RonaldSchotman/Zebro/ReadMe.txt

This is the root of the Zebro Archive

Although the modules of different Zebro's should be interchangeable, they are organised according to the Zebro type that they are designed for.
