RonaldSchotman/Zebro/DeciZebro/LegModule/Hardware/Motor_driver_V1.0_ordered/Motor_driver_Mathijs/BOM_motor_driver_mathijs.xlsx

BOM power system
 |  |  |  |  | Total price | 33.36
Description | Value | Schematic Sheet | KiCad reference | Amount | Price | Price total | Manufacuter | Supplier | Ordercode | Artikel nr. | link
Resistors
Resistor 0603 | 120E |  | R7, R8 | 2 | 0.0126 | 0.0126 | YAGEO | Farnell | 9238379 | RC0603FR-07120RL | Link (http://nl.farnell.com/yageo-phycomp/rc0603fr-07120rl/res-thick-film-120r-1-0-1w-0603/dp/9238379)
Resistor 0603 | 150E |  | R19, R20, R21 | 3 | 0.0103 | 0.0309 | WELWYN | Farnell | 2078902 | ASC0603-150RFT5 | Link (http://nl.farnell.com/welwyn/asc0603-150rft5/res-thick-film-150r-1-0-1w-0603/dp/2078902)
Resistor 0603 | 2k7 | ATXmega, Driver, Sensors | R6, R9, R10, R14, R15 | 5 | 0.01 | 0.05 | WALSIN | Farnell | 2502439 | WR06X2701FTL | Link (http://nl.farnell.com/walsin/wr06x2701ftl/resistor-thick-film-2k7-1-75v/dp/2502439)
Resistor 0603 | 10k | Driver, ATXmega | R3 | 1 | 0.0038 | 0.0038 | Multicomp | Farnell | 2447230 | MCWR06X1002FTL | Link (http://nl.farnell.com/multicomp/mcwr06x1002ftl/res-thick-film-10k-1-0-1w-0603/dp/2447230)
Resistor 0603 | 16.9k |  | R1 | 1 | 0.0035 | 0.0035 | Multicomp | Farnell | 2447263 | MCWR06X1692FTL | Link (http://nl.farnell.com/multicomp/mcwr06x1692ftl/res-thick-film-16-9kohm-1-0-1w/dp/2447263)
Resistor 0603 | 22k |  | R4 | 1 | 0.0032 | 0.0032 | Multicomp | Farnell | 2447299 | MCWR06X2202FTL | Link (http://nl.farnell.com/multicomp/mcwr06x2202ftl/res-thick-film-22kohm-1-0-1w/dp/2447299)
Resistor 0603 | 47k |  | R12 | 1 | 0.0032 | 0.0035 | Multicomp | Farnell | 2447376 | MCWR06X4702FTL | Link (http://nl.farnell.com/multicomp/mcwr06x4702ftl/res-thick-film-47kohm-1-0-1w/dp/2447376)
Resistor 0603 | 68k |  | R13 | 1 | 0.0035 | 0.0035 | Multicomp | Farnell | 2447420 | MCWR06X6802FTL | Link (http://nl.farnell.com/multicomp/mcwr06x6802ftl/res-thick-film-68kohm-1-0-1w/dp/2447420)
Resistor 0603 | 330k |  | R5 | 1 | 0.004 | 0.004 | Multicomp | Farnell | 2447338 | MCWR06X3303FTL | Link (http://nl.farnell.com/multicomp/mcwr06x3303ftl/res-thick-film-330kohm-1-0-1w/dp/2447338)
Resistor 0603 | 100k | Buck Converter | R2 | 1 | 0.0079 | 0.0079 | YAGEO | Farnell | 9238727 | RC0603FR-07100KL | Link (http://nl.farnell.com/yageo-phycomp/rc0603fr-07100kl/res-thick-film-100k-1-0-1w-0603/dp/9238727)
Resistor 0603 | 1M |  | R11, R16, R17, R18 | 4 | 0.0013 | 0.0052 | Multicomp | Farnell | 9330410 | MC0063W060311M | Link (http://nl.farnell.com/multicomp/mc0063w060311m/res-thick-film-1m-1-0-063w-0603/dp/9330410)
Capacitors
Capacitor 0603 | 1u | Driver | C2, C10, C15, C16, C17 | 2 | 0.0251 | 0.0502 | Murata | Farnell | 9527699 | GRM188R60J105KA01D | Link (http://nl.farnell.com/murata/grm188r60j105ka01d/cap-mlcc-x5r-1uf-6-3v-0603/dp/9527699)
Capacitor 0603 | 100nF | Sensors, ATXmega | C5, C6, C9, C11, C12, C13, C14, C18, C19, C20, C21 | 11 | 0.0129 | 0.1419 | WALSIN | Farnell | 2496833 | 0603B104K250CT | Link (http://nl.farnell.com/walsin/0603b104k250ct/capacitor-mlcc-x7r-0-1uf-25v-0603/dp/2496833)
Capacitor 0603 | 2.2u | Buck Converter | C3 | 1 | 0.0986 | 0.0986 | Murata | Farnell | 2611926 | GRM188R6YA225KA12D | Link (http://nl.farnell.com/murata/grm188r6ya225ka12d/cap-mlcc-x5r-2-2uf-35v-0603/dp/2611926)
Capacitor 1206 | 22u | Buck Converter | C4 | 1 | 0.281 | 0.281 | YAGEO | Farnell | 1458914 | CC1206KKX5R5BB226 | Link (http://nl.farnell.com/yageo-phycomp/cc1206kkx5r5bb226/cap-mlcc-x5r-22uf-6-3v-1206/dp/1458914)
Capacitor 0603 | 1n |  | C7, C8 | 2 | 0.0059 | 0.0118 | Multicomp | Farnell | 2627426 | MC0603B102K250CT | Link (http://nl.farnell.com/multicomp/mc0603b102k250ct/cap-mlcc-x7r-1000pf-25v-0603/dp/2627426)
Capacitor | 22u |  | C1 | 1 | 0.014 | 0.014 | Multicomp | Farnell | 2611332 | MCVKZ016M220DA1L | Link (http://nl.farnell.com/multicomp/mcvkz016m220da1l/cap-alu-elec-22uf-16v-rad-can/dp/2611332)
Diodes
LED | KPH-1608SGC | ATXmega | D1, D2 | 2 | 0.0444 | 0.0888 | Kingbright | Farnell | 2426215 | KPH-1608SGC | Link (http://nl.farnell.com/kingbright/kph-1608sgc/led-green-12mcd-568nm-smd/dp/2426215)
TVS | CDSOD323-T08 | Connectors | D3 | 1 | 0.0236 | 0.0236 | Bourns | Farnell | 2341919 | CDSOD323-T08 | Link (http://nl.farnell.com/bourns/cdsod323-t08/diode-array-tvs-350w-8v-sod-323/dp/2341919)
Zener | MMSZ4684 |  | D4 | 1 | 0.0611 | 0.0611 | Fairchild | Farnell | 2454044 | MMSZ4684 | Link (http://nl.farnell.com/fairchild-semiconductor/mmsz4684/zener-diode-0-5w-3-3v-sod-123/dp/2454044)
Inductors
Inductor | 10uH | Buck Converter | L1 | 1 | 0.594 | 0.594 | Vishay/Dale | Mouser | 70-IFSC1515AHER100M0 | IFSC1515AHER100M01 | Link (http://nl.mouser.com/ProductDetail/Vishay/IFSC1515AHER100M01/)
IC's
DRV8871 | Motor driver | Motor system | U1 | 1 | 2.7 | 2.7 | TI | Mouser | 595-DRV8871DDAR | DRV8871DDAR | Link (http://nl.mouser.com/ProductDetail/Texas-Instruments/DRV8871DDAR/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)
SM451 | Hall-sensor | Sensors | U4 | 1 | 0.971 | 0.971 | Honeywell | Mouser | 785-SM451R | SM451R | Link (http://nl.mouser.com/ProductDetail/Honeywell/SM451R/)
NCT75MNR2G | Temperature sensor | Sensors | U6 | 1 | 0.604 | 0.604 | On Semiconductor | Mouser | 863-NCT75DR2G | NCT75DR2G | Link (http://nl.mouser.com/ProductDetail/ON-Semiconductor/NCT75DR2G/)
TPS62177 | Buck Converter | Buck Converter | U2 | 1 | 1.44 | 1.44 | TI | Mouser | 595-TPS62177DQCR | TPS62177DQCR | Link (http://nl.mouser.com/ProductDetail/Texas-Instruments/TPS62177DQCR/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)
ATXMEGA32D4 | ATXMEGA | Xmega | U7 | 1 | 2.87 | 2.87 | Atmel | Farnell | 1748558 | ATXMEGA32D4-AU | Link (http://nl.farnell.com/atmel/atxmega32d4-au/mcu-8bit-avr-xmega-32mhz-tqfp/dp/1748558)
TCUT1350 | Photo Encoder | Sensors | U3 | 2 | 1.57 | 3.14 | Vishay | Farnell | 2424451 | TCUT1350X01 | Link (http://nl.farnell.com/vishay/tcut1350x01/sensor-optical-3mm-phototransistor/dp/2424451)
ACS710 | Current Sensor | Sensors | U5 | 1 | 4.17 | 4.17 | Allegro | Farnell | 2057422 | ACS710KLATR-6BB-T | Link (http://nl.farnell.com/allegro-microsystems/acs710klatr-6bb-t/current-sensor-16soic/dp/2057422)
SRV05 | TVS diode 4 I/O |  | U18, U11 | 2 | 1.53 | 3.06 | Bourns | Farnell | 1824870 | CDSOT23-SRV05-4 | Link (http://www.farnell.com/datasheets/1915363.pdf?_ga=1.110976581.1356917053.1479124336)
PCA9517 | Buffer | Connectors | U10 | 1 | 0.912 | 0.912 | NXP | Farnell | 2212064 | PCA9517ADP | Link (http://nl.farnell.com/nxp/pca9517adp/ic-repeater-i2c-bus-8tssop/dp/2212064)
Overig
Conn 01x04 |  | Connectors | P3, P6 | 1 | 0.163 | 0.163 | Wurt Elektronik | Farnell | 2356155 | 61300411121 | Link (http://nl.farnell.com/wurth-elektronik/61300411121/header-2-54mm-pin-tht-vertical/dp/2356155)
Conn 02x01 screw |  | Connectors | P1, P4 | 2 | 0.937 | 1.874 | TE | Farnell | 2112482 | 282834-2 | Link (http://nl.farnell.com/te-connectivity-buchanan/282834-2/terminal-block-wire-to-brd-2pos/dp/2112482)
Conn 02x03 |  | Connectors | P5 | 1 | 0.161 | 0.161 | Harwin | Farnell | 1022231 | M20-9980346 | Link (http://nl.farnell.com/harwin/m20-9980346/connector-header-tht-2-54mm-6way/dp/1022231)
Conn 02x04 smd | Data | Connectors | P2 | 1 | 0.546 | 0.546 | Samtec | Farnell | 2056012 | TSM-104-02-T-DV | Link (http://nl.farnell.com/samtec/tsm-104-02-t-dv/header-2-54mm-smt-8way/dp/2056012)
Fuse |  |  |  | 1 | 2.72 | 2.72 | Littlefuse | Farnell | 9922407 | 0452004.NRL | Link (http://nl.farnell.com/littelfuse/0452004-nrl/fuse-antisurge-smd-4a/dp/9922407?MER=sy-me-pd-mi-acce)
Fuse holder |  | Connectors | F1 | 1 | 6.54 | 6.54 | Littlefuse | Farnell | 9943765 | 0154004.DRT | Link (http://nl.farnell.com/littelfuse/0154004-drt/fuse-smd-4a-omni-block-time-delay/dp/9943765)
