RonaldSchotman/Zebro/StandardReferences/Styleguide/introduction.tex

\epigraph{Consistency is what matters the most in triggering something important to your life}{\textit{Abdul Rauf}}
\section{Introduction}
 
When writing a report --- or any other document --- it can be hard to maintain a consistent style throughout your work.
Yet, consistency of style can have an enormous impact in how professional the end result looks.
Most people barely manage to maintain a single style when working individually, let alone when working in a team.
As an attempt to create consistency the work of our team, this style guide was created.
Please read it carefully, and add information as needed.
Also keep in mind that this is a \emph{dynamic} document.
Therefore you are expected to regularly check this document for changes.
