RonaldSchotman/Zebro/StandardReferences/Styleguide/styleguide.tex

\documentclass[11pt,a4paper]{article}
\usepackage[utf8]{inputenc}
\usepackage{amsmath}
\usepackage{amsfonts}
\usepackage{amssymb}
\usepackage{graphicx}
\usepackage{epigraph}
\usepackage{float}
\usepackage{cleveref}
\usepackage{caption}
\usepackage{booktabs}
\usepackage{siunitx}

\sisetup{exponent-product = \cdot, per-mode=fraction}

\title{Zebro Style Guide for Publications}
\date{\today}

\begin{document}
\maketitle
\tableofcontents
\clearpage

\include{introduction} \clearpage
\include{general} \clearpage
\include{figuresAndTables} \clearpage
\include{termsAndAbbreviations} \clearpage
\include{technicalNotation} \clearpage

\end{document}
