RonaldSchotman/Zebro/StandardReferences/Styleguide/termsAndAbbreviations.tex

\epigraph{Let all things be done decently and in order.
}{\textit{I Corinthians, XIV. 40.}}
\section{Terms and abbreviations}

\paragraph{Technical terms}
Unless otherwise specified,
use the primary notation used by the English Wikipedia for all technical terms.

\paragraph{Acronyms}
Always use the acronyms package for acronyms.

\paragraph{BAP}
When referring the the Bachelor graduation project, use the acronym BAP
