RonaldSchotman/Zebro/DeciZebro/LegModule/Hardware/Motor_driver_V1.0_ordered/Motor_driver_Mathijs/Motor_driver.pdf

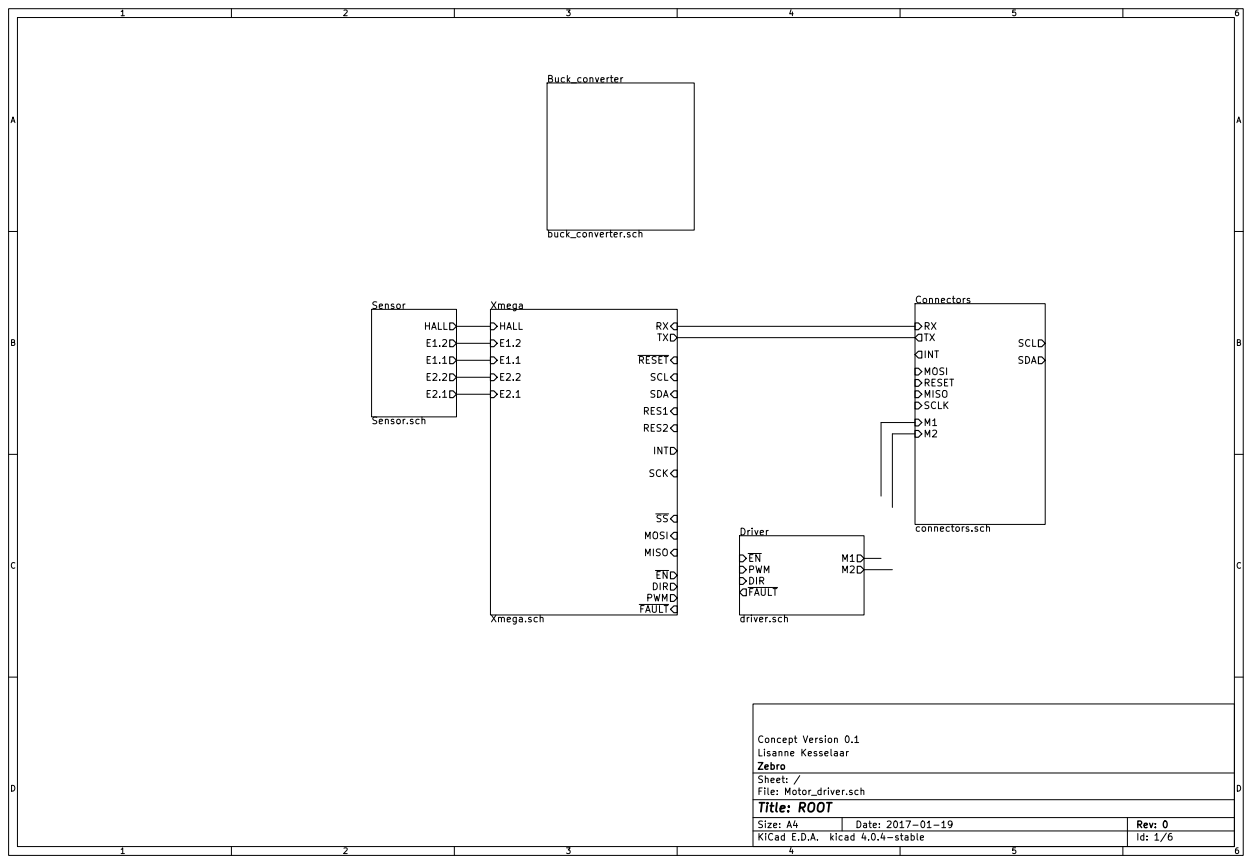
[picture p1: page 1]

Lisanne Kesselaar Concept Version 0.1

File: Motor_driver.sch Sheet: / Zebro

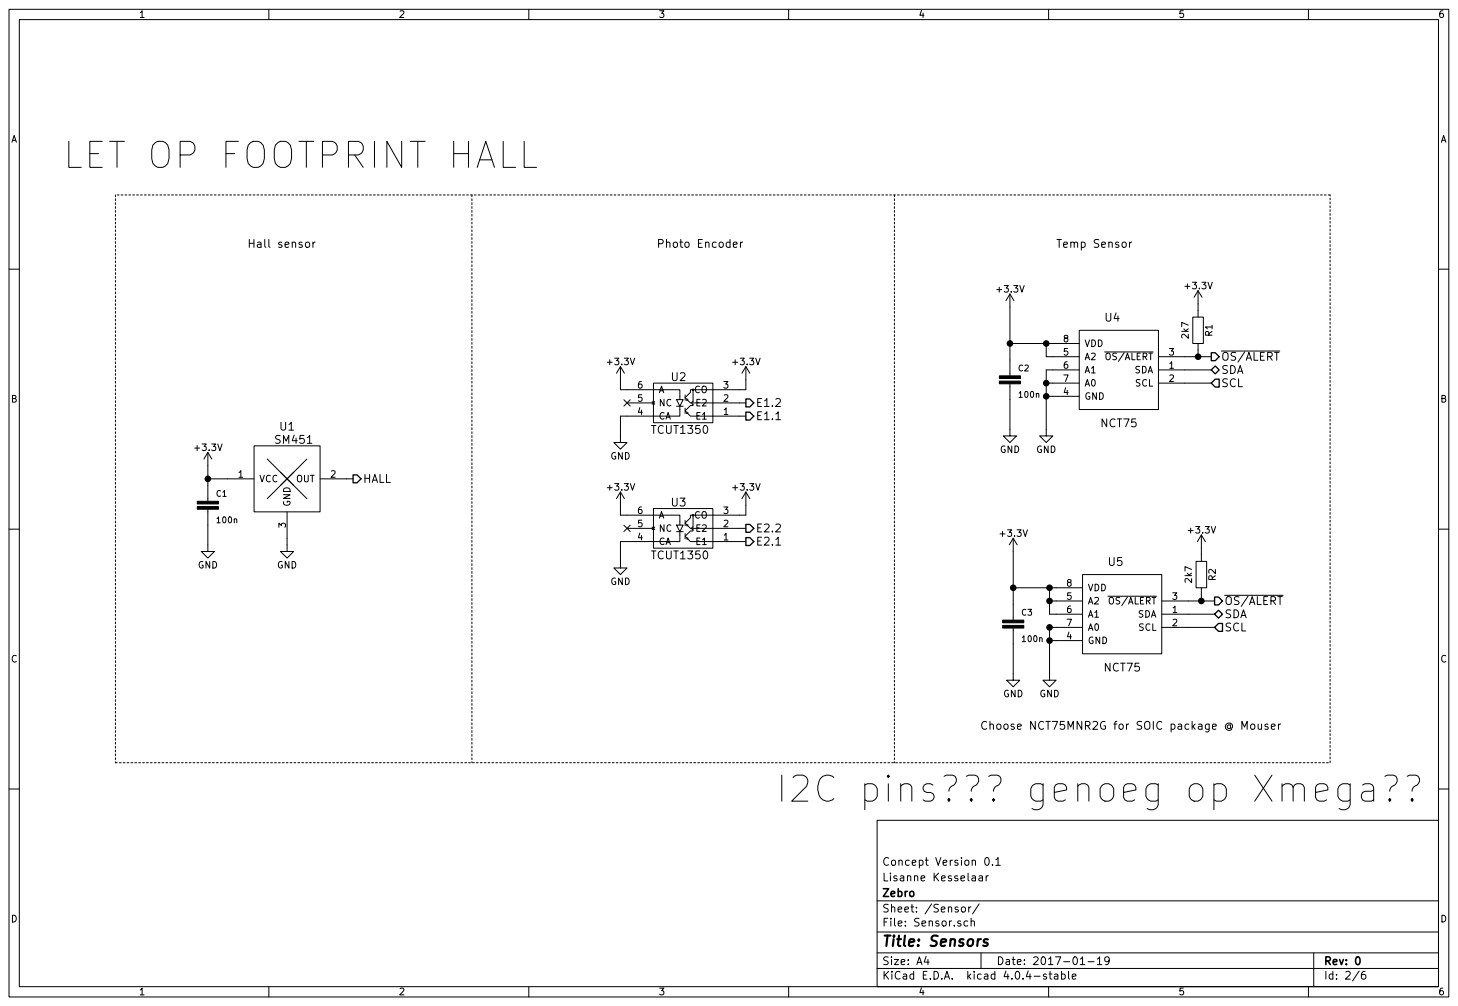
[picture p2: page 2]

Choose NCT75MNR2G for SOIC package @ Mouser

I2C pins??? genoeg op Xmega??

File: Sensor.sch Sheet: /Sensor/ Zebro

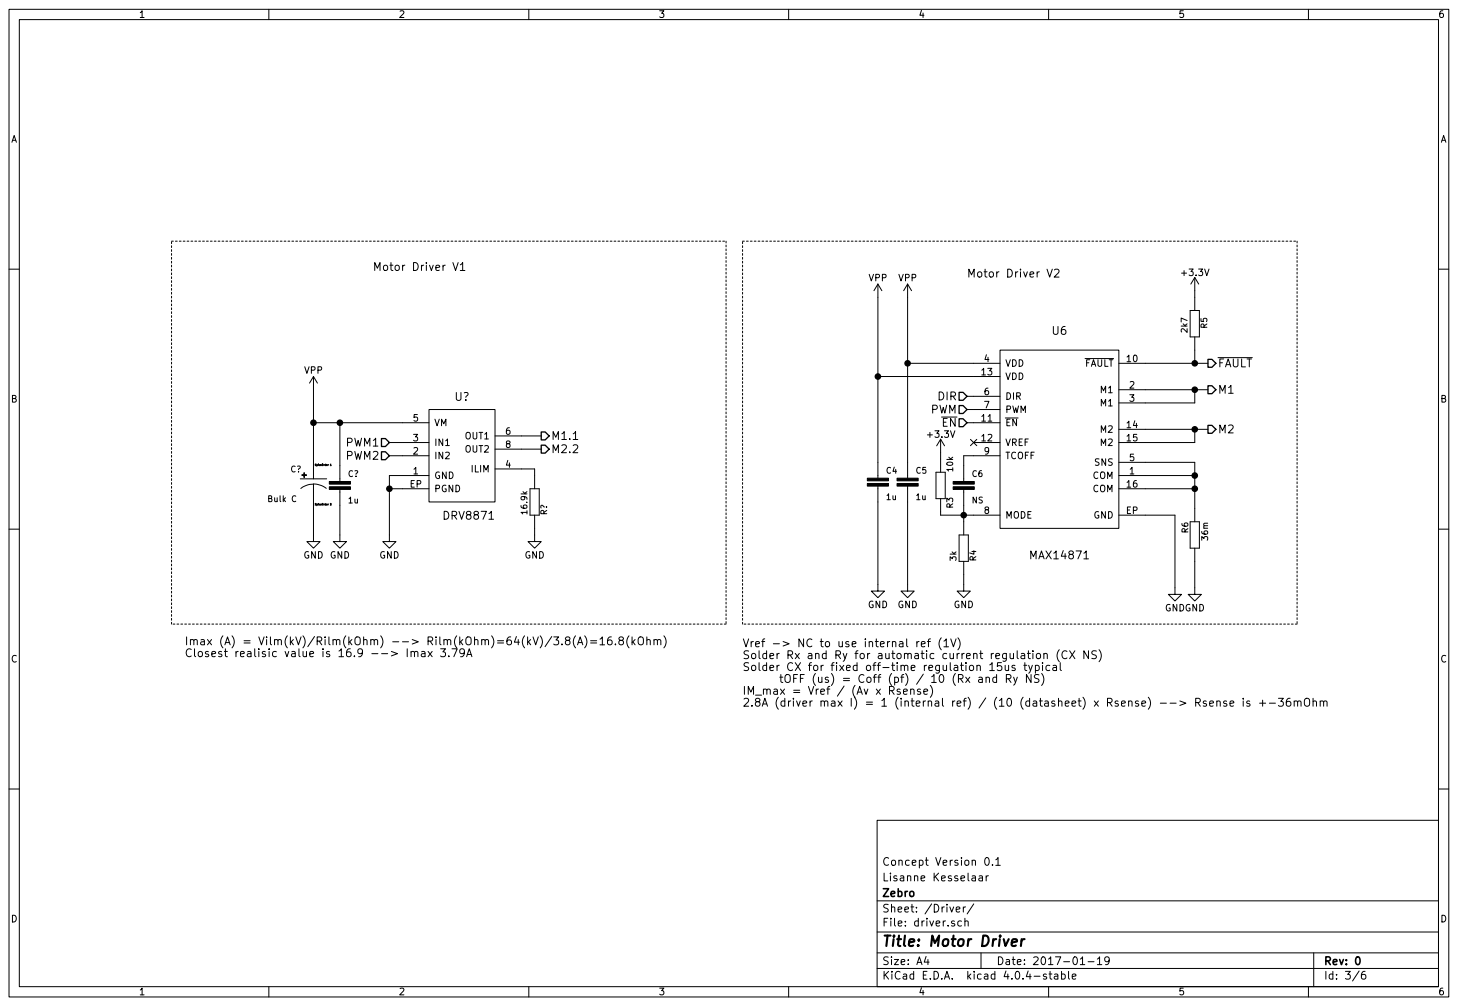
[picture p3: page 3]

C6 NS GND Vref -> NC to use internal ref (1V)

Imax (A) = Vilm(kV)/Rilm(kOhm) --> Rilm(kOhm)=64(kV)/3.8(A)=16.8(kOhm)
Closest realisic value is 16.9 --> Imax 3.79A

Solder Rx and Ry for automatic current regulation (CX NS)
Solder CX for fixed off-time regulation 15us typical
tOFF (us) = Coff (pf) / 10 (Rx and Ry NS)
IM_max = Vref / (Av x Rsense)

Id: 3/6 Title: Motor Driver File: driver.sch Sheet: /Driver/ Zebro

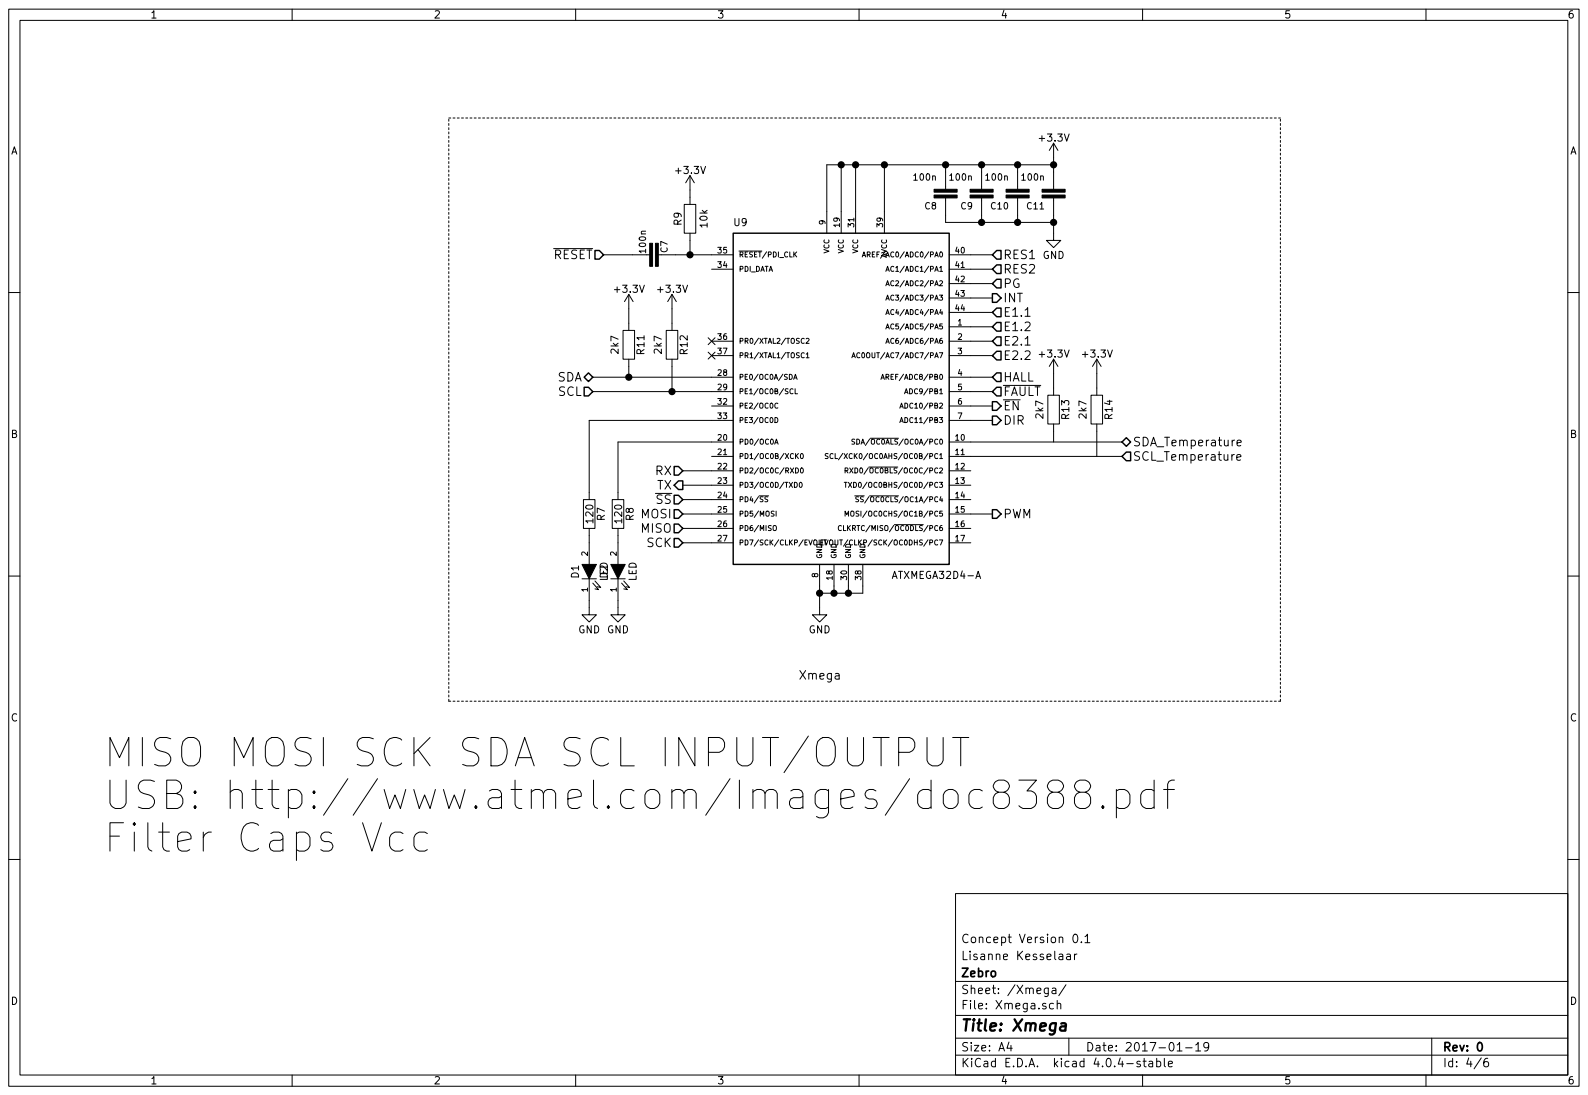
[picture p4: page 4]

9 SDA/OC0ALS/OC0A/PC0 10 PD0/OC0A 20 GND 30 AREF/AC0/ADC0/PA0 40 SCL/XCK0/OC0AHS/OC0B/PC1 11 PD1/OC0B/XCK0 21 VCC 31 AC1/ADC1/PA1 41 RXD0/OC0BLS/OC0C/PC2 12 PD2/OC0C/RXD0 22 PE2/OC0C 32 AC2/ADC2/PA2 42

1 2 D2 LED 120 R7 120 R8 GND GND PWM

MISO MOSI SCK SDA SCL INPUT/OUTPUT
USB: http://www.atmel.com/Images/doc8388.pdf
Filter Caps Vcc

Lisanne Kesselaar Concept Version 0.1

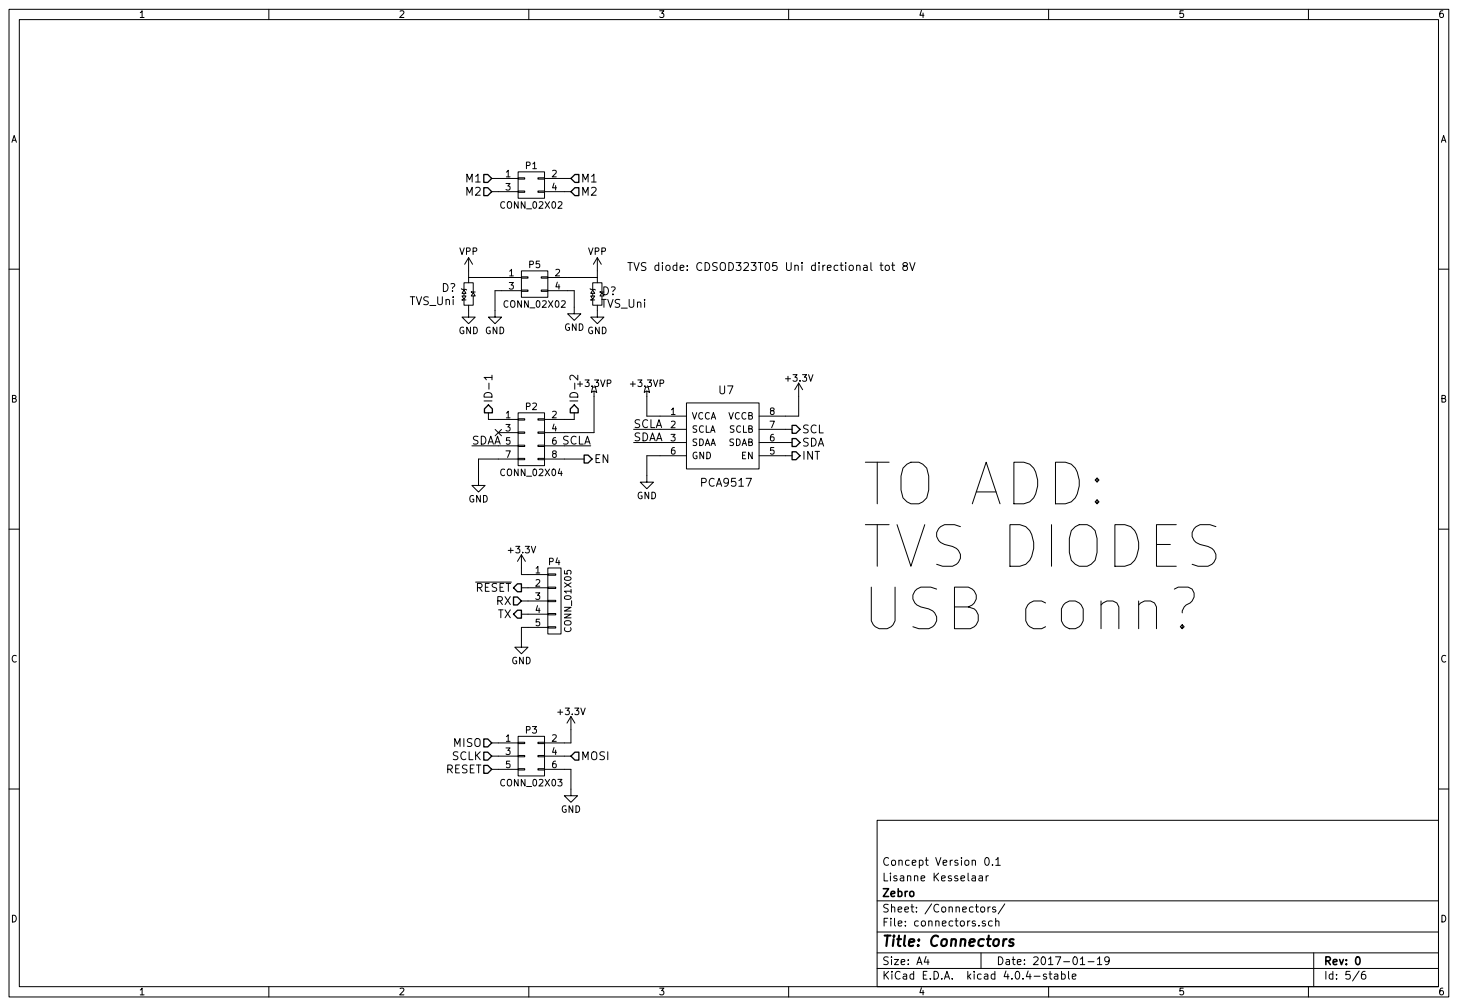
[picture p5: page 5]

Lisanne Kesselaar Concept Version 0.1

File: connectors.sch Sheet: /Connectors/ Zebro

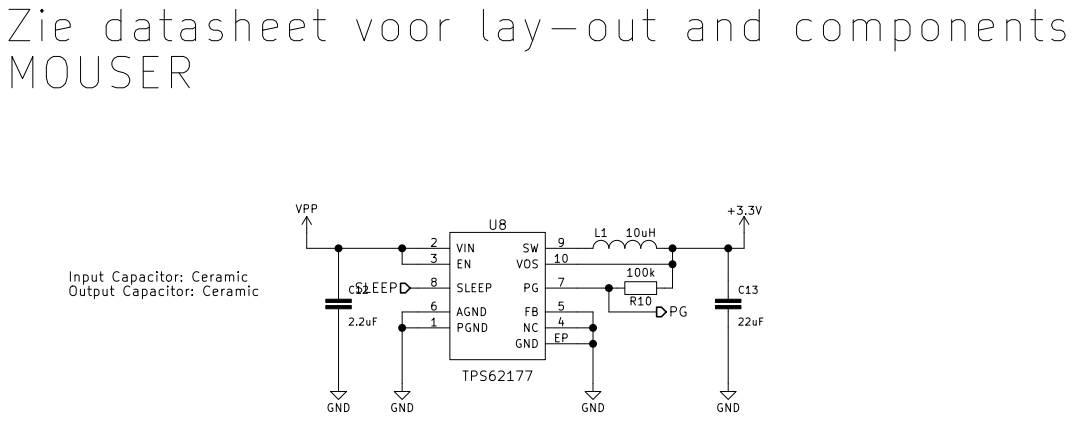
[picture p6: page 6]

File: buck_converter.sch
Id: 6/6 Title: Buck Converter
