RonaldSchotman/Zebro/DeciZebro/LegModule/Hardware/Motor_driver_V1.0_ordered/Motor_driver_Mathijs/Schema_pdf/Motor_driver.pdf

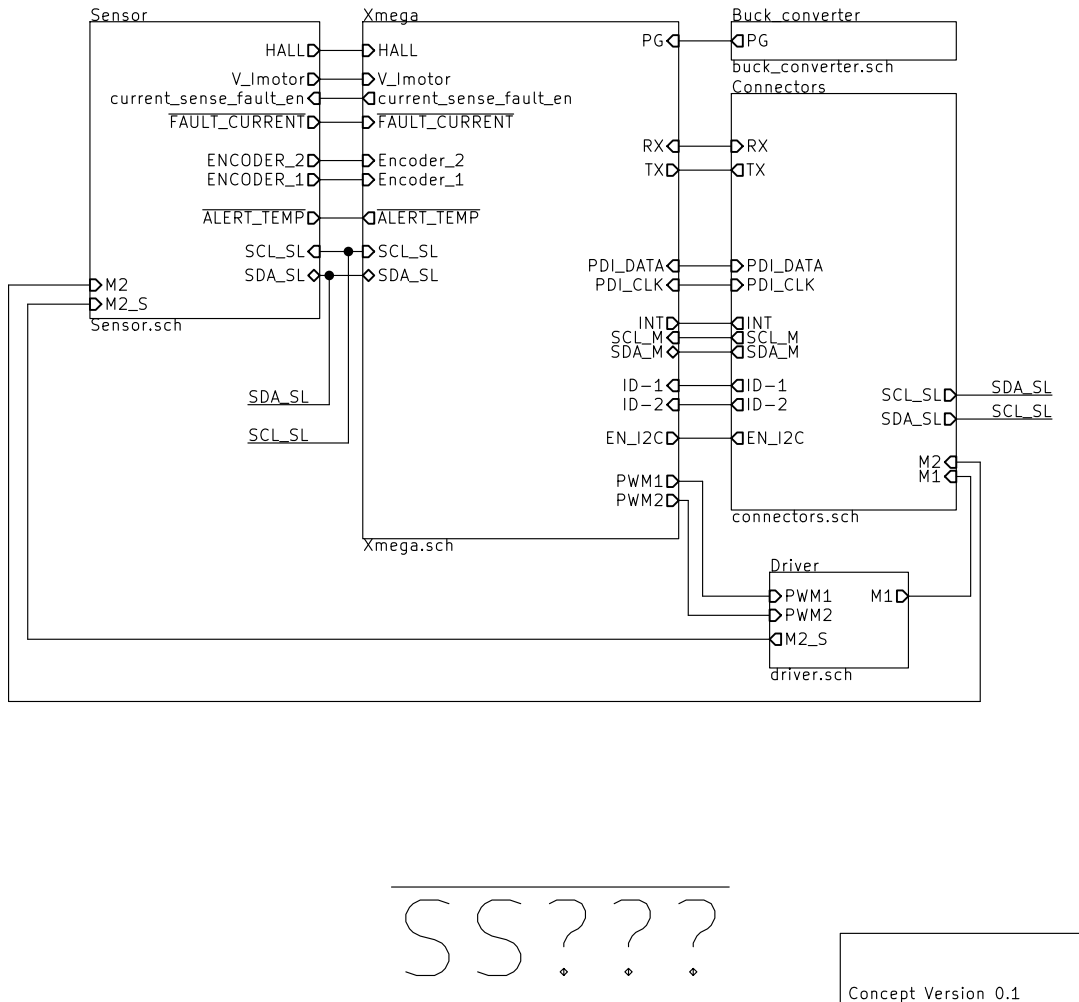
[picture p7: page 1]

File: Motor_driver.sch Sheet: / Zebro

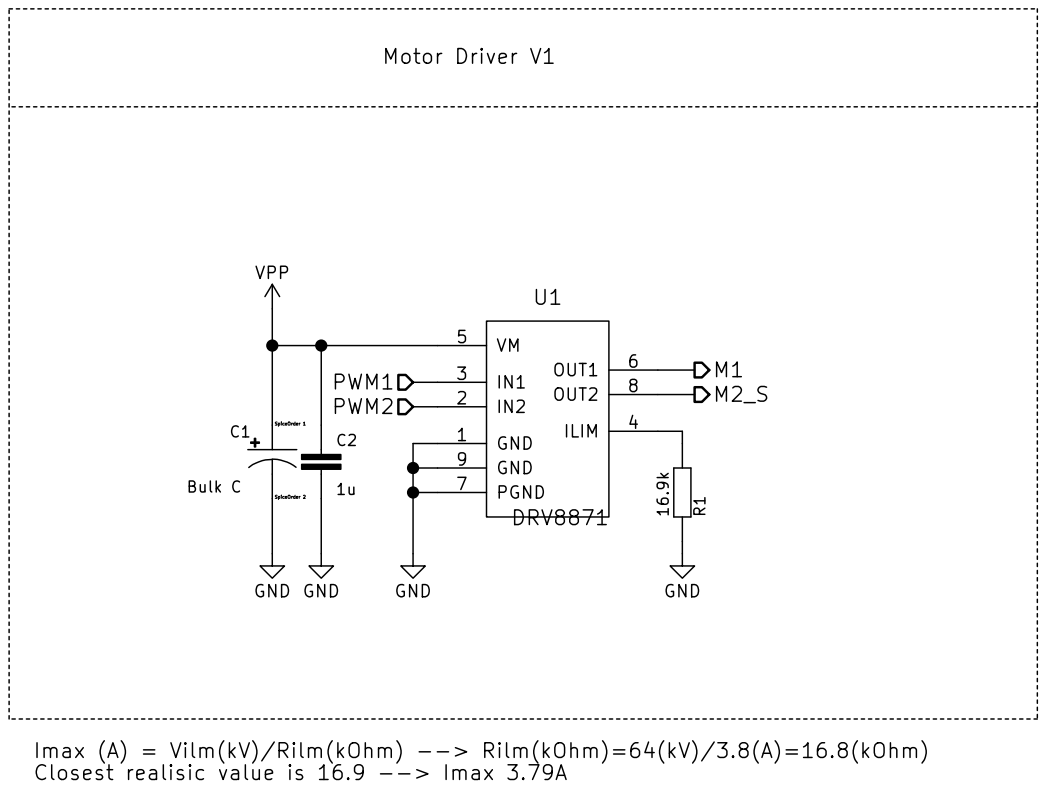
[picture p8: page 2]

Imax (A) = Vilm(kV)/Rilm(kOhm) --> Rilm(kOhm)=64(kV)/3.8(A)=16.8(kOhm)
Closest realisic value is 16.9 --> Imax 3.79A

Id: 2/6 Title: Motor Driver File: driver.sch Sheet: /Driver/ Zebro

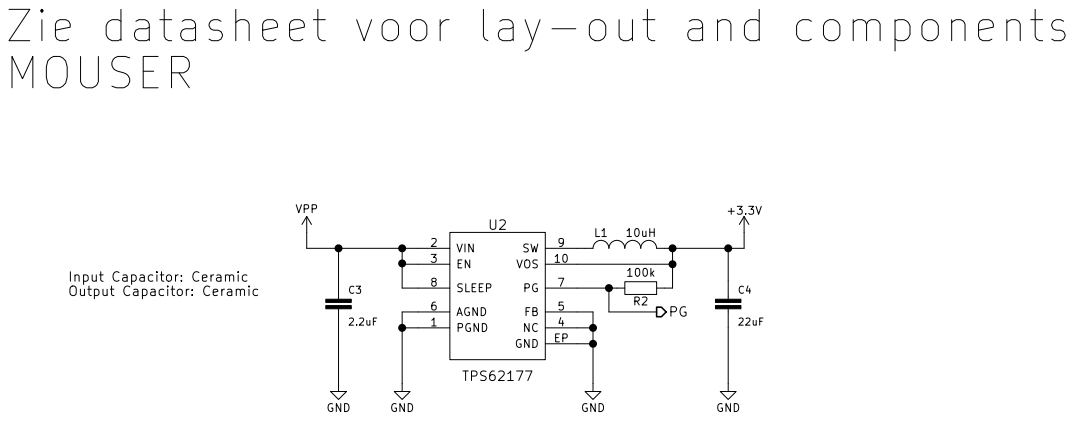
[picture p9: page 3]

+3.3V Zie datasheet voor lay-out and components
MOUSER

File: buck_converter.sch
Id: 3/6 Title: Buck Converter

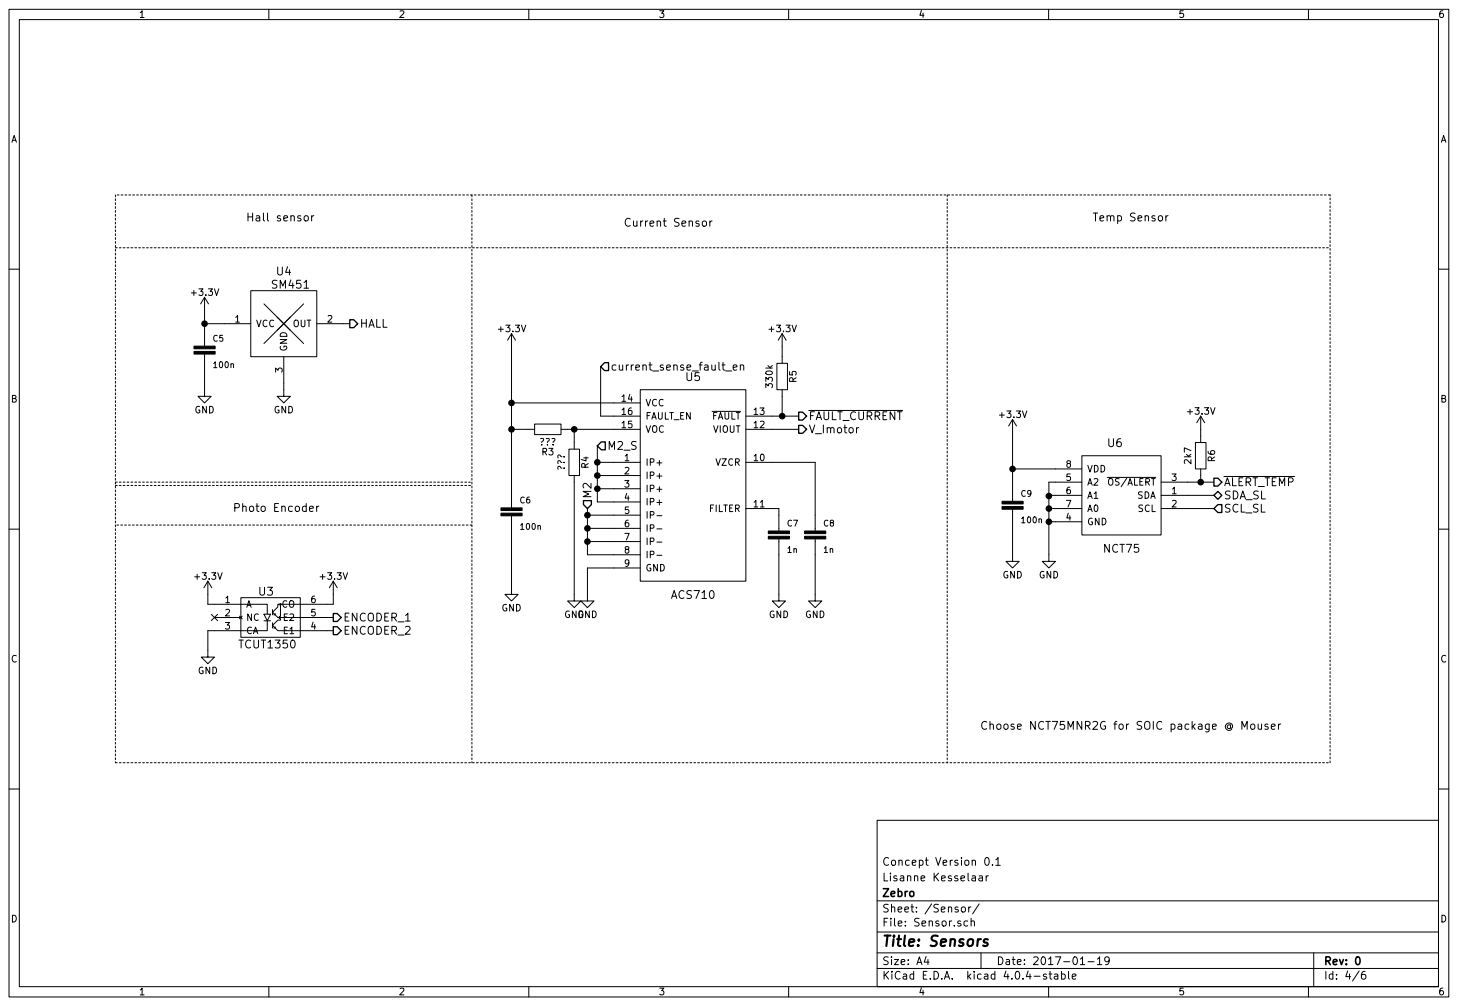
[picture p10: page 4]

File: Sensor.sch Sheet: /Sensor/ Zebro

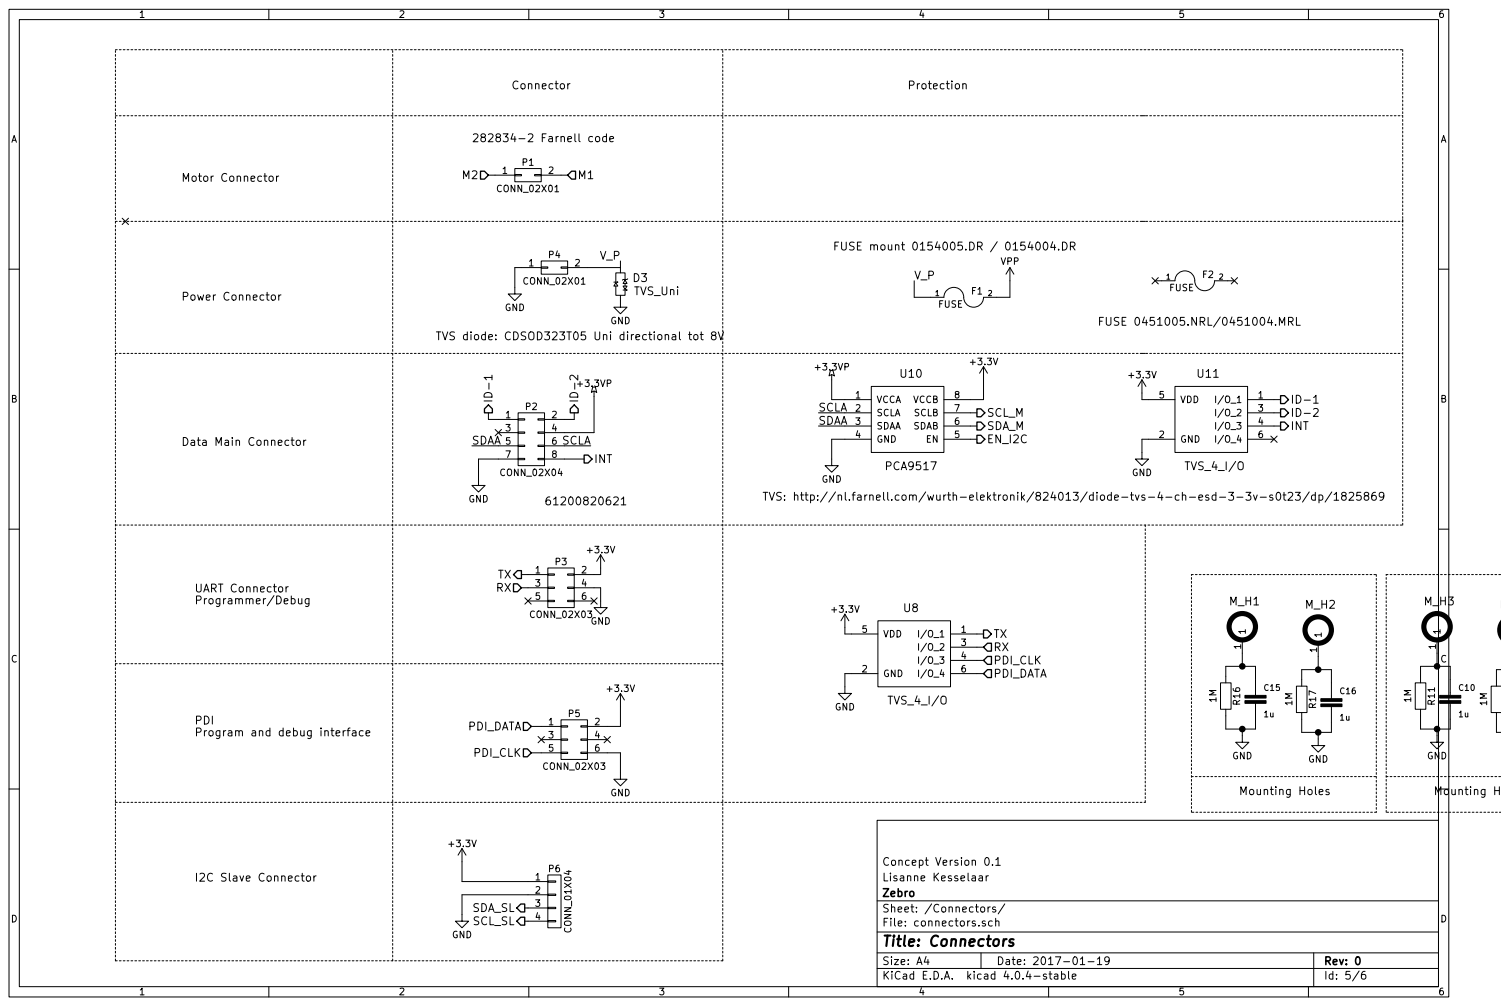
[picture p11: page 5]

VPP FUSE mount 0154005.DR / 0154004.DR

TVS: http://nl.farnell.com/wurth-elektronik/824013/diode-tvs-4-ch-esd-3-3v-s0t23/dp/1825869

UART Connector
Programmer/Debug PDI Program and debug interface

Lisanne Kesselaar Concept Version 0.1

File: connectors.sch Sheet: /Connectors/ Zebro

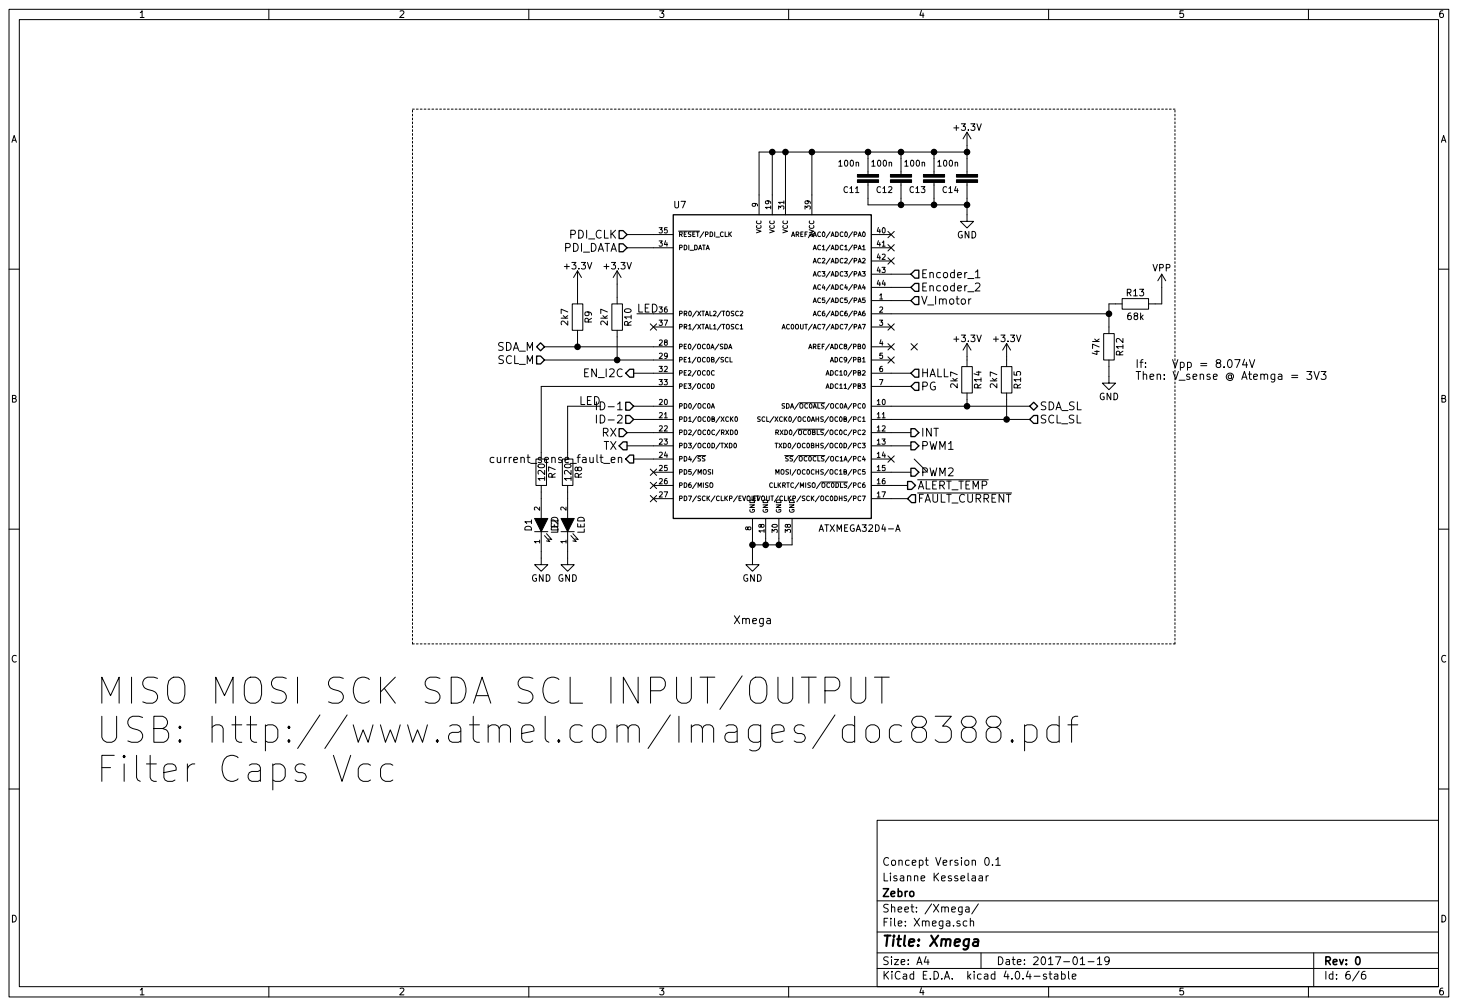
[picture p12: page 6]

9 SDA/OC0ALS/OC0A/PC0 10 PD0/OC0A 20 GND 30 AREF/AC0/ADC0/PA0 40 SCL/XCK0/OC0AHS/OC0B/PC1 11 PD1/OC0B/XCK0 21 VCC 31 AC1/ADC1/PA1 41 RXD0/OC0BLS/OC0C/PC2 12 PD2/OC0C/RXD0 22 PE2/OC0C 32 AC2/ADC2/PA2 42

1 2 D2 LED 120 R7 120 R8 GND GND PWM2 HALL MISO MOSI SCK SDA SCL INPUT/OUTPUT

USB: http://www.atmel.com/Images/doc8388.pdf
Filter Caps Vcc

Lisanne Kesselaar Concept Version 0.1
