RonaldSchotman/Zebro/DeciZebro/LegModule/Hardware/Motor_driver_V1.0_ordered/Motor_driver_Mathijs/Motor_driver.kicad_pcb

## KiCad design DeciZebro/LegModule/Hardware/Motor_driver_V1.0_ordered/Motor_driver_Mathijs/Motor_driver.kicad_pcb (2017-02-24)

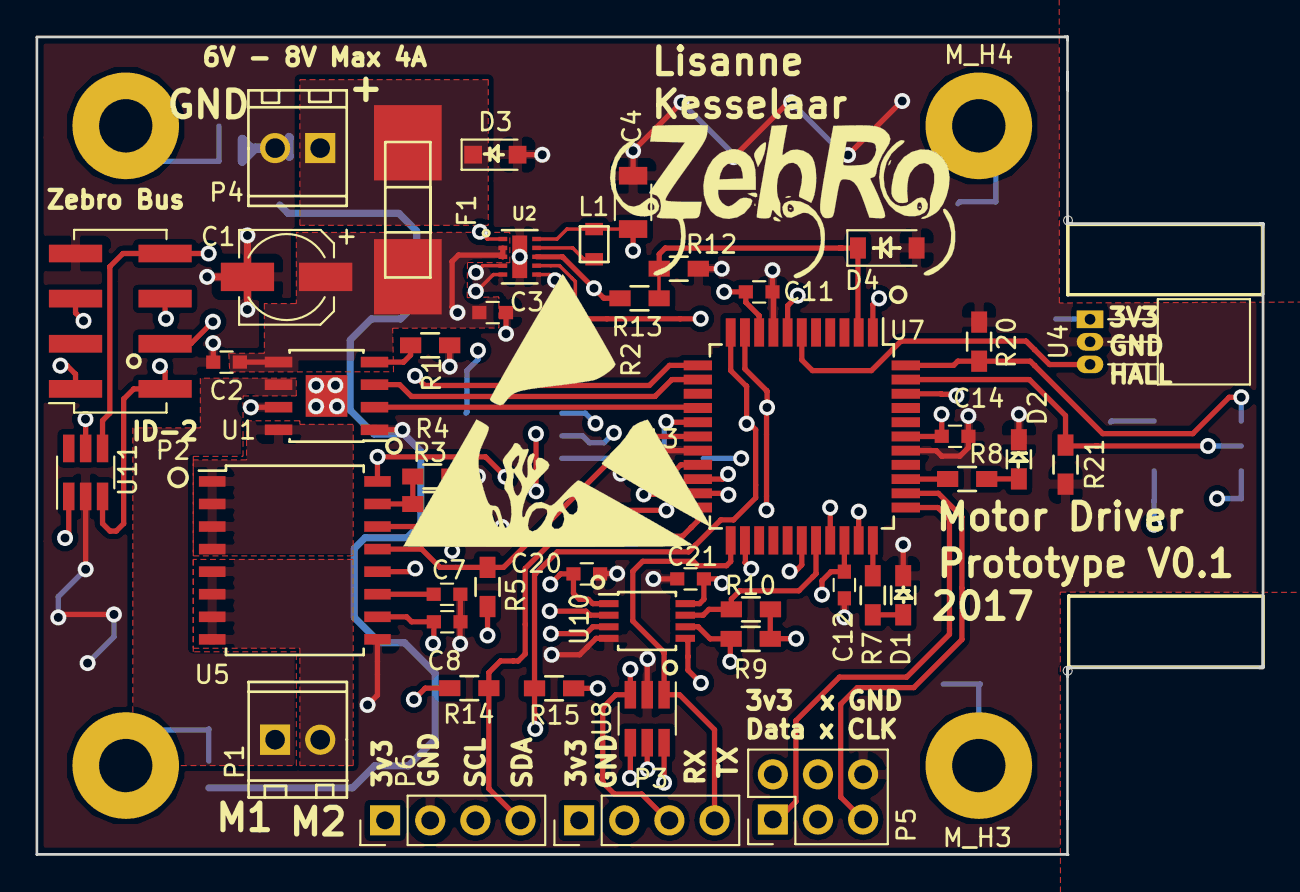
[picture p13: board Motor_driver.kicad_pcb from above]

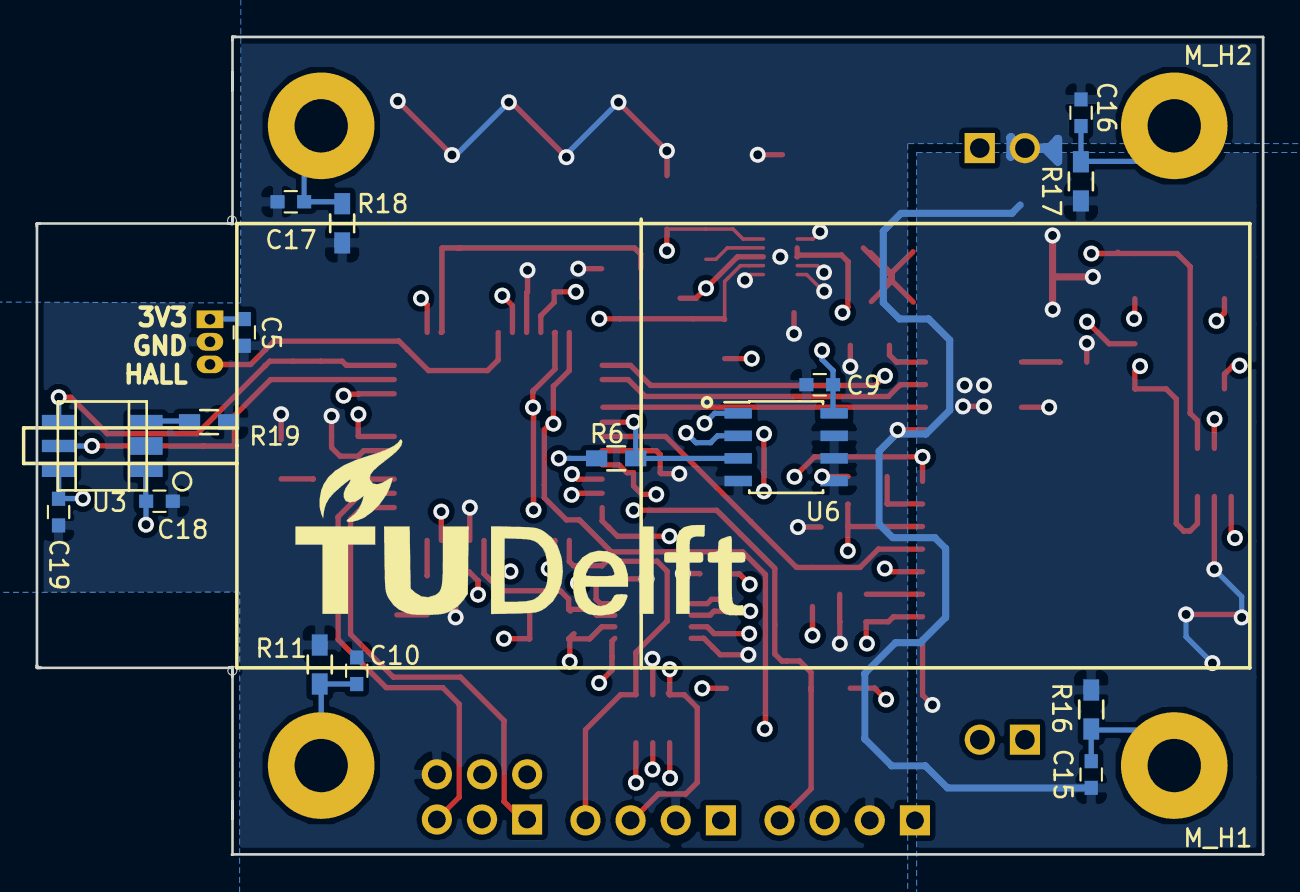
[picture p14: board Motor_driver.kicad_pcb from below]

Board: 4 copper layers, 69.0 x 46.0 mm, 68 parts (18 on the bottom side), 47 nets.

Parts:
C1: Bulk C; CP_Elec_5x5.3
C2, C10, C15, C16, C17: 1u; C_0603
C3: 2.2uF; C_0603
C4: 22uF; C_1206
C5, C6, C9, C11, C12, C13, C14, C18, C19, C20, C21: 100n; C_0603
C7, C8: 1n; C_0603
D1, D2: LED; R_0603_HandSoldering
D3: TVS_Uni; D_SOD-323_HandSoldering
D4: ZENER; D_SOD-123
F1: FUSE; litle_fuse_154_serie
L1: 10uH; Inductor-vishay-motor-driver
M_H1, M_H2, M_H3, M_H4: Mounting_Hole; MountingHole_3mm_Pad
P1, P4: CONN_02X01; screw_terimnal_2.54mm_pitch
P2: CONN_02X04; Socket_Strip_Straight_2x04_Pitch2.54mm_SMD
P3, P6: CONN_01X04; Pin_Header_Straight_1x04_Pitch2.54mm
P5: CONN_02X03; Pin_Header_Straight_2x03_Pitch2.54mm
R1: 16.9k; R_0603_HandSoldering
R2: 100k; R_0603_HandSoldering
R3: 10k; R_0603_HandSoldering
R4: 22k; R_0603_HandSoldering
R5: 330k; R_0603_HandSoldering
R6, R9, R10, R14, R15: 2k7; R_0603_HandSoldering
R7, R8: 120; R_0603_HandSoldering
R11, R16, R17, R18: 1M; R_0603_HandSoldering
R12: 47k; R_0603_HandSoldering
R13: 68k; R_0603_HandSoldering
R19, R20, R21: 150E; R_0603_HandSoldering
U1: DRV8871; SOIC-8-1EP_3.9x4.9mm_Pitch1.27mm
U2: TPS62177; WSON-10-2x3
U3: TCUT1350
U4: SM451; TO-92_Horizontal2_Inline_Narrow_Oval
U5: ACS710; SOIC-16W_7.5x10.3mm_Pitch1.27mm
U6: NCT75; SOIC-8_3.9x4.9mm_Pitch1.27mm
U7: ATXMEGA32D4-A; LQFP-44_10x10mm_Pitch0.8mm
U8, U11: TVS_4_I/O; SOT-23-6_Handsoldering
U10: PCA9517; TSSOP-8_3x3mm_Pitch0.65mm

Connections:
+3.3VP: C20.1, P2.4, U10.1
+3V3: C4.1, C5.1, C6.1, C9.1, C11.2, C12.2, C13.2, C14.2, C18.1, C19.1, C21.1, L1.2, P3.1, P5.2, P6.1, R2.1, R3.1, R5.1, R6.1, R9.1, R10.1, R14.1, R15.1, U2.10, U3.1, U3.6, U4.1, U5.14, U6.8, U7.9, U7.19, U7.31, U7.39, U8.5, U10.8, U11.5
/Buck_converter/PG: R2.2, U2.7, U7.7
/Connectors/EN_I2C: U7.32, U10.5
/Connectors/ID-1: P2.1, U7.20, U11.1
/Connectors/ID-2: P2.2, U7.21, U11.3
/Connectors/INT: P2.8, U7.12, U11.4
/Connectors/M1: P1.2, U1.6
/Connectors/M2: P1.1, U5.5, U5.6, U5.7, U5.8
/Connectors/PDI_CLK: P5.5, U7.35, U8.4
/Connectors/PDI_DATA: P5.1, U7.34, U8.6
/Connectors/RX: P3.3, U7.22, U8.3
/Connectors/SCLA: P2.6, U10.2
/Connectors/SCL_M: R10.2, U7.29, U10.7
/Connectors/SDAA: P2.5, U10.3
/Connectors/SDA_M: R9.2, U7.28, U10.6
/Connectors/TX: P3.4, U7.23, U8.1
/Connectors/V_P: D3.1, F1.1, P4.2
/Driver/M2_S: U1.8, U5.1, U5.2, U5.3, U5.4
/Driver/PWM1: U1.3, U7.13
/Driver/PWM2: U1.2, U7.15
/SCL_SL: P6.3, R15.2, U6.2, U7.11
/SDA_SL: P6.4, R14.2, U6.1, U7.10
/Sensor/ENCODER_1: R21.1, U3.5, U7.43
/Sensor/ENCODER_2: R20.1, U3.4, U7.44
/Sensor/HALL: U4.3, U7.6
/Sensor/V_Imotor: U5.12, U7.1
/Sensor/V_Imotor0V: C8.1, U5.10, U7.42
/Sensor/current_sense_fault_en: U5.16, U7.24
/Sensor/~ALERT_TEMP: R6.2, U6.3, U7.16
/Sensor/~FAULT_CURRENT: R5.2, U5.13, U7.17
/Xmega/LED: R8.1, U7.36
GND: C1.2, C2.2, C3.2, C4.2, C5.2, C6.2, C7.2, C8.2, C9.2, C10.2, C11.1, C12.1, C13.1, C14.1, C15.2, C16.2, C17.2, C18.2, C19.2, C20.2, C21.2, D1.1, D2.1, D3.2, D4.2, P2.7, P3.2, P4.1, P5.6, P6.2, R1.1, R4.2, R11.2, R12.2, R16.2, R17.2, R18.2, R19.2, R20.2, R21.2, U1.1, U1.7, U1.9, U2.1, U2.4, U2.5, U2.6, U2.EP, U4.2, U5.9, U6.4, U6.5, U6.6, U6.7, U7.8, U7.18, U7.30, U7.38, U8.2, U10.4, U11.2
unnamed: C7.1, U5.11
unnamed: C10.1, M_H3.1, R11.1
unnamed: C15.1, M_H1.1, R16.1
unnamed: C16.1, M_H2.1, R17.1
unnamed: C17.1, M_H4.1, R18.1
unnamed: D1.2, R7.2
unnamed: D2.2, R8.2
unnamed: D4.1, R12.1, R13.2, U7.2
unnamed: L1.1, U2.9
unnamed: R1.2, U1.4
unnamed: R3.2, R4.1, U5.15
unnamed: R7.1, U7.33
unnamed: R19.1, U3.3
VPP: C1.1, C2.1, C3.1, F1.2, R13.1, U1.5, U2.2, U2.3, U2.8
