RonaldSchotman/Zebro/DeciZebro/LegModule/Software/PootModule/PootModule/src/main.c

/**
 * Leg Module Deci Zebro
 * The Zebro Project
 * Delft University of Technology
 * 2017
 *
 * Filename: main.c
 *
 * Description:
 * Main file for the deci zebro leg module
 *
 * Authors:
 * Daniel Booms -- d.booms@solcon.nl
 *  
 */
#include <stdint.h>
#include <asf.h>
#include <avr/io.h>
#include "../inc/clock.h"
#include "../inc/globals.h"
#include "../inc/interrupts.h"
#include "../inc/leds.h"
#include "../inc/vregs.h"
#include "../inc/uart1.h"
#include "../inc/hbridge.h"
#include "../inc/errors.h"
#include "../inc/address.h"
#include "../inc/zebrobus.h"
#include "../inc/encoder.h"
#include "../inc/motion.h"

int main (void)
{
	/*some debugging code*/
		/* Initialise system clock */
		sysclk_init();
		sysclk_set_source(SYSCLK_SRC_RC32MHZ);
		sysclk_set_prescalers(SYSCLK_PSADIV_1, SYSCLK_PSBCDIV_1_1);
		clock_init();
		/* Initalise delay functions */
		delay_init(sysclk_get_cpu_hz());
	
	/* Initialise board parameters*/
	board_init();
	
	/* Insert application code here, after the board has been initialized. */
		
		leds_init();
		
		vregs_init();
		uart1_init_dma();
		interrupts_enable();
		leds_set_LD1();
		hbridge_init();
		address_init();
		zebrobus_slave_init();
		encoder_init();
		motion_init();
			
	
	while (1){
		//UART_Transmit(0xAA);
		//UART1_TX_PORT.OUTTGL |= UART1_TX_PIN;
		zebrobus_process_write_requests();
		motion_drive_h_bridge();
		uart1_trigger_dma_once();
	}
}
