RonaldSchotman/Zebro/DeciZebro/LegModule/Software/PootModule/PootModule/src/vregs.c

/**
 * Leg Module Deci Zebro
 * The Zebro Project
 * Delft University of Technology
 * 2017
 *
 * Filename: vregs.c
 *
 * Description:
 * Implementation of the virtual registers used for communication
 * using ZebroBus (I2C1) and UART1
 *
 * !! IMPORTANT !!
 * In order for the host debug tools to work, it is important that
 * the structure of this file remains the same! Be careful when making
 * changes.
 *
 * The debug tool reads out the values between the BEGIN FIELD NAME DEFINITIONS
 * and END FIELD NAME DEFININTIONS statements. Leave these lines intact!
 * It than generates labels for the registers by remove the '#define VREGS_'
 * that every label has. Thus, in order for proper labels to be generated, you
 * should start all vregs name definitions with 'VREGS_' and put them between
 * the BEGIN and END statements.
 *
 * Authors:
 * Piet De Vaere -- Piet@DeVae.re
 * Daniël Booms	-- d.booms@solcon.nl
 */

#include "asf.h"
#include "../inc/interrupts.h"
#include "../inc/vregs.h"
#include "../inc/globals.h"

uint8_t vregs[VREGS_FILE_TOTAL_SIZE];
uint8_t vregs_buffer[VREGS_NUM_OF_BUFFERS][VREGS_FILE_TOTAL_SIZE];
static int8_t buffer_selector = 0;

/**
 * Initialise the virtual registers. Set all fields to their default values.
 */
void vregs_init(void){
	int16_t cursor;

	/* set everything to zero */
	for(cursor = 0; cursor < VREGS_FILE_TOTAL_SIZE; cursor++){
		vregs[cursor] = 0;
	}

	vregs[VREGS_SERIAL_ID] = GLOBALS_SERIAL_ID;
	vregs[VREGS_PRODUCT_ID] = GLOBALS_PRODUCT_ID;
	vregs[VREGS_PRODUCT_VERSION] = GLOBALS_PRODUCT_VERSION;
	vregs[VREGS_SOFTWARE_VERSION] = GLOBALS_SOFTWARE_VERSION;
	vregs[VREGS_MOTOR_VOLTAgE] = GLOBALS_MOTOR_VOLTAGE;
	vregs[VREGS_FILE_TOTAL_SIZE - 1] = VREGS_SYNC_4;
	vregs[VREGS_FILE_TOTAL_SIZE - 2] = VREGS_SYNC_3;
	vregs[VREGS_FILE_TOTAL_SIZE - 3] = VREGS_SYNC_2;
	vregs[VREGS_FILE_TOTAL_SIZE - 4] = VREGS_SYNC_1;
	vregs[VREGS_FILE_TOTAL_SIZE - 5] = VREGS_SYNC_0;

	/* also initialise the buffers */
	vregs_writeout();
	vregs_writeout();
}

/**
 * Write a value to a virtual register.
 * Return: 0 is successful, 1 if failed
 */
int8_t vregs_write(uint32_t address, uint8_t data){
	if (address < VREGS_FILE_SIZE){
		vregs[address] = data;
		return 0;
	}
	else return 1;
}

/**
 * Read a value from a virtual register.
 * Before you use this function, are you sure you want to do this?
 * It might be a bad idea ...
 * Return the value to be read
 */
uint8_t vregs_read(uint32_t address){
	if (address < VREGS_FILE_SIZE){
		return vregs[address];
	}
	else return 0;
}

/**
 * Same as vregs_read, but now read from the buffered vregs
 */
uint8_t vregs_read_buffer(uint32_t address){
	if (address < VREGS_FILE_SIZE){
		return vregs_buffer[buffer_selector][address];
	}
	else return 0;
}

/**
 * Copy the vregs to the buffer, where they can be accessed over ZebroBus
 * and UART1
 */
int8_t vregs_writeout(void){
	int16_t cursor;

	for(cursor = 0; cursor < VREGS_FILE_TOTAL_SIZE; cursor++){
		vregs_buffer[!buffer_selector][cursor] = vregs[cursor];
	}

	/**
	 * BEGIN critical section
	 */
	interrupts_disable();

	buffer_selector = !buffer_selector;

	interrupts_enable();
	/**
	 * END critical section
	 */

	return 0;
}

/**
 * Return a pointer to the buffered vregs
 */
uint8_t *vregs_get_buffer_address(void){
	return (vregs_buffer[buffer_selector]);
}
