RonaldSchotman/Zebro/DeciZebro/LegModule/Software/Pootmodule/Pootmodule/inc/clock.h

/**
 * Leg Module Deci Zebro
 * The Zebro Project
 * Delft University of Technology
 * 2017
 
 * Filename: clock.h
 *
 * Description:
 * Configures global clock settings
 *
 * Authors:
 * Martijn de Rooij -- 
 * Daniel Booms	-- d.booms@solcon.nl
 */

#ifndef __CLOCK_H__
#define __CLOCK_H__

void clock_init(void);

#endif /* __CLOCK_H_ */
