RonaldSchotman/Zebro/(commit log)

2017-02-20 Added Standard References: Codeguide, Styleguide, and Zebrobus standard specification
    [field_assignments.ods]
2017-02-24 Added Deci Zebro Leg Module hardware KiCad design files and documentation
    [BOM_motor_driver_mathijs.xlsx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]
2017-03-02 Added Atmel-studios project and reference documents of the mcu, got toolchain working, verfied with shining led
2017-03-02 blinking led!!!!1!, added .pdf to gitignore
2017-03-03 Added global interrupt control
2017-03-03 started to implement UART on the leg module, not finished yet
2017-03-09 Continiueing on UART, implemented DMA feed
2017-03-14 UART finished, but now i have 10^6 problems because of a device change
    [uart1.c, uart1.h]
2017-03-17 Uart still not working
    [UART_portD.c, UART_portD.h, main.c, uart1.c, uart1.h]
2017-03-23 Added hbridge, fixed some UART errors
    [clock.c, clock.h, encoder.c, encoder.h, globals.h, hbridge.c, hbridge.h]
2017-03-24 H-bridge working, adder error handling, started implementing i2c
    [I2c.c, errors.c, errors.h, main.c, zebrobus.c, zebrobus.h]
2017-04-04 Fixed i2c enable bug, added basic motion control, added arduino sketch for accessing zebrobus which does not work yet
    [encoder.c, i2c.ino, main.c, motion.c, zebrobus.c, zebrobus.h]
